Cpt-Quantum/uart-to-ws2812/3d-view.png

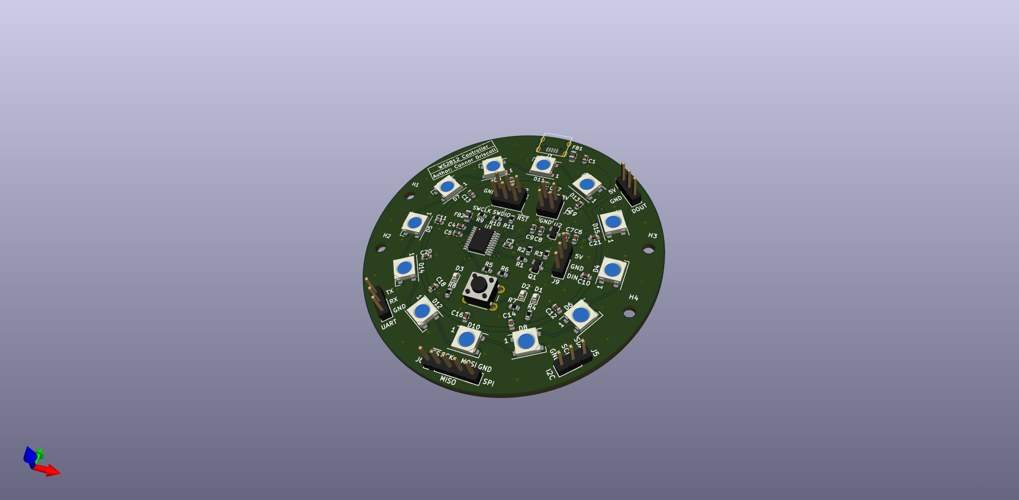
3d-view.png
