Cpt-Quantum/uart-to-ws2812/uart_to_ws2812b.kicad_pcb

## KiCad design uart_to_ws2812b.kicad_pcb (2021-03-27)

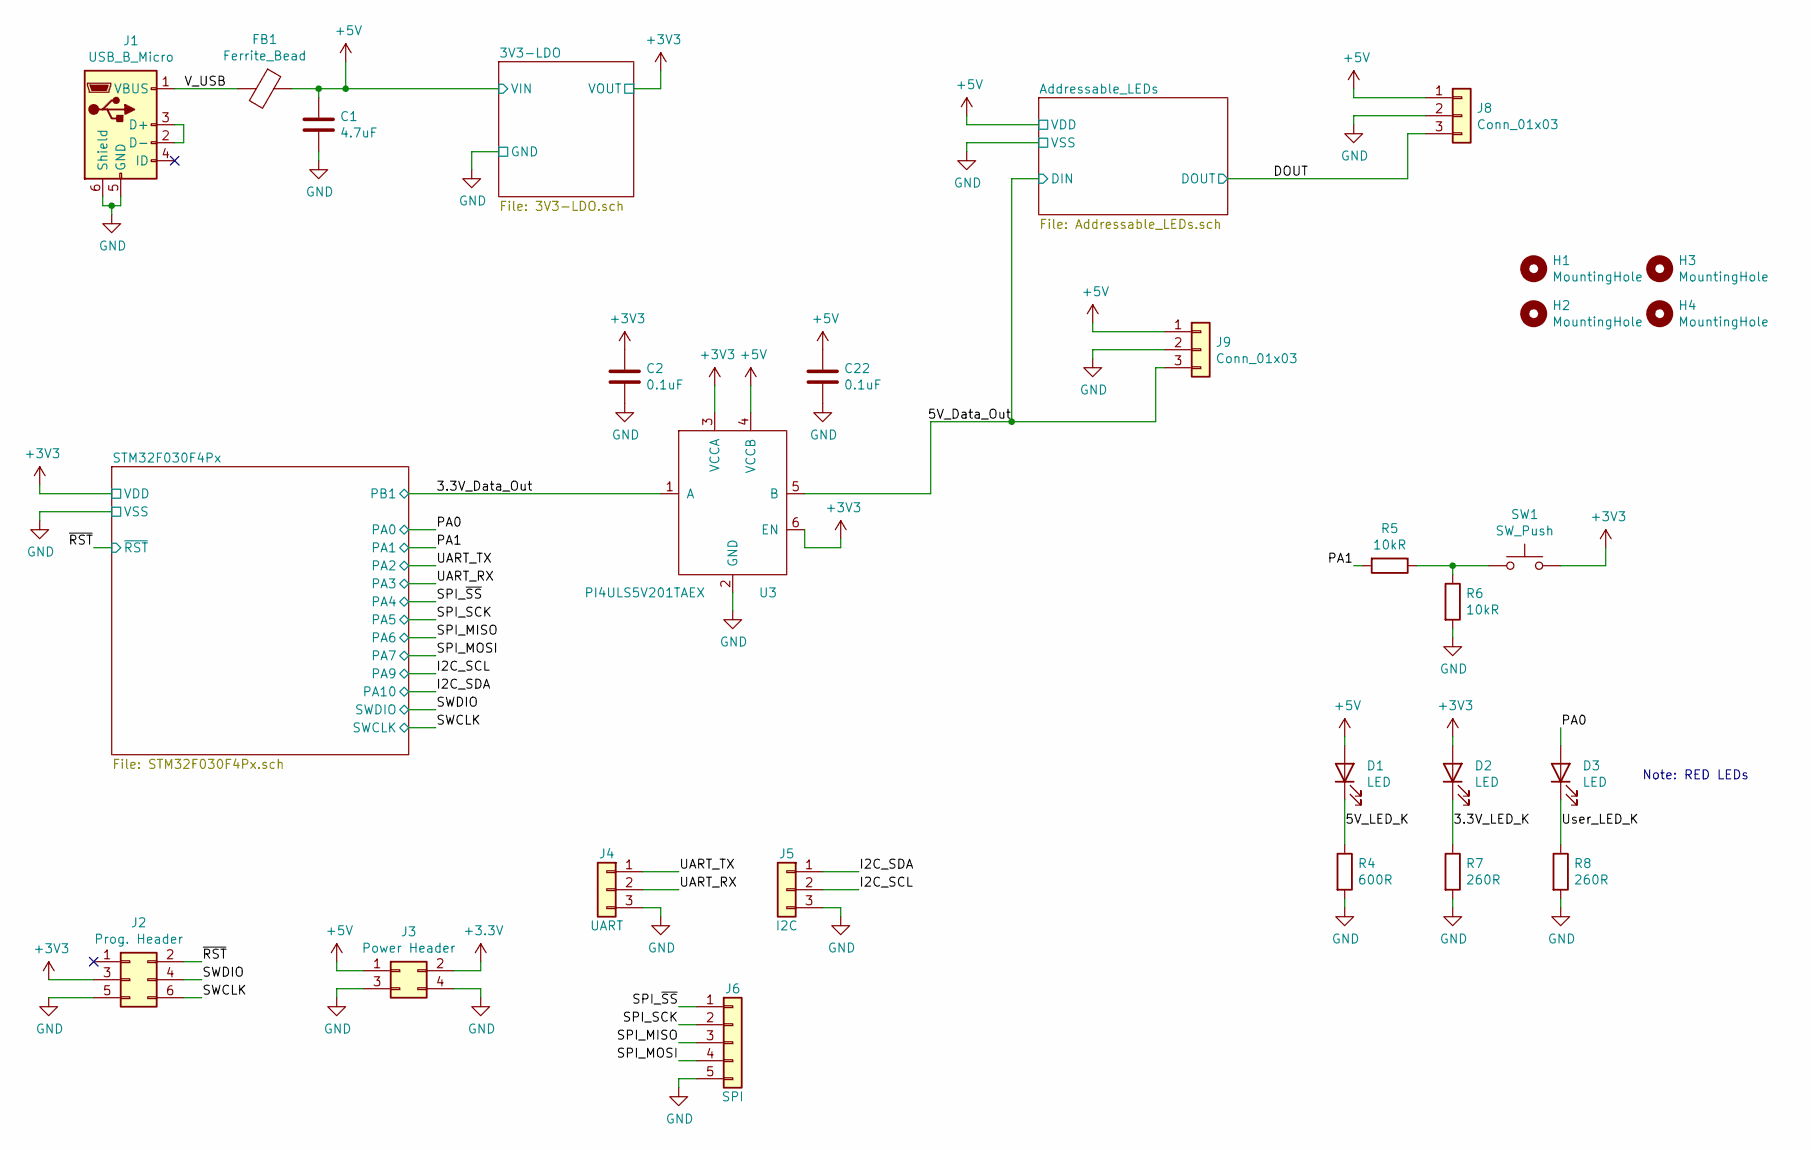
[picture p2: schematic uart_to_ws2812b.sch]

Parts:
C1: 4.7uF; C_0603_1608Metric; Mfr Part # CL10A475KQ8NNNC
C2, C22: 0.1uF; C_0603_1608Metric
D1, D2, D3: LED; LED_0603_1608Metric
FB1: Ferrite_Bead; L_0805_2012Metric
H1, H2, H3, H4: MountingHole; MountingHole_2.5mm
J1: USB_B_Micro; USB-MicroB
J2: Prog. Header; PinHeader_2x03_P2.54mm_Vertical
J3: Power Header; PinHeader_2x02_P2.54mm_Vertical
J4: UART; PinHeader_1x03_P2.54mm_Vertical
J5: I2C; PinHeader_1x03_P2.54mm_Vertical
J6: SPI; PinHeader_1x05_P2.54mm_Vertical
J8, J9: Conn_01x03; PinHeader_1x03_P2.54mm_Vertical
R4: 600R; R_0603_1608Metric
R5, R6: 10kR; R_0603_1608Metric
R7, R8: 260R; R_0603_1608Metric
SW1: SW_Push; SW_PUSH_6mm_H5mm
U3: PI4ULS5V201TAEX; SOT-23-6; Mfr Part # PI4ULS5V201TAEX

Connections:
+3V3: C2.1, D2.2 (A), J2.3, J3.2, SW1.2, U3.3 (VCCA), U3.6 (EN); also elsewhere on the board
+5V: C1.1, C22.1, D1.2 (A), FB1.1, J3.1, J8.1, J9.1, U3.4 (VCCB); also elsewhere on the board
/3.3V_Data_Out: U3.1 (A); also elsewhere on the board
/3.3V_LED_K: D2.1 (K), R7.1
/5V_Data_Out: J9.3, U3.5 (B); also elsewhere on the board
/5V_LED_K: D1.1 (K), R4.1
/DOUT: J8.3; also elsewhere on the board
/I2C_SCL: J5.2; also elsewhere on the board
/I2C_SDA: J5.1; also elsewhere on the board
/PA0: D3.2 (A); also elsewhere on the board
/PA1: R5.2; also elsewhere on the board
/SPI_MISO: J6.3; also elsewhere on the board
/SPI_MOSI: J6.4; also elsewhere on the board
/SPI_SCK: J6.2; also elsewhere on the board
/SPI_~SS: J6.1; also elsewhere on the board
/SWCLK: J2.6; also elsewhere on the board
/SWDIO: J2.4; also elsewhere on the board
/UART_RX: J4.2; also elsewhere on the board
/UART_TX: J4.1; also elsewhere on the board
/User_LED_K: D3.1 (K), R8.1
/V_USB: FB1.2, J1.1 (VBUS)
/~RST: J2.2; also elsewhere on the board
GND: C1.2, C2.2, C22.2, J1.5 (GND), J1.6 (Shield), J2.5, J3.3, J3.4, J4.3, J5.3, J6.5, J8.2, J9.2, R4.2, R6.2, R7.2, R8.2, U3.2 (GND); also elsewhere on the board
unnamed: J1.2 (D-), J1.3 (D+)
unnamed: R5.1, R6.1, SW1.1

Notes on the sheet:
Note: RED LEDs

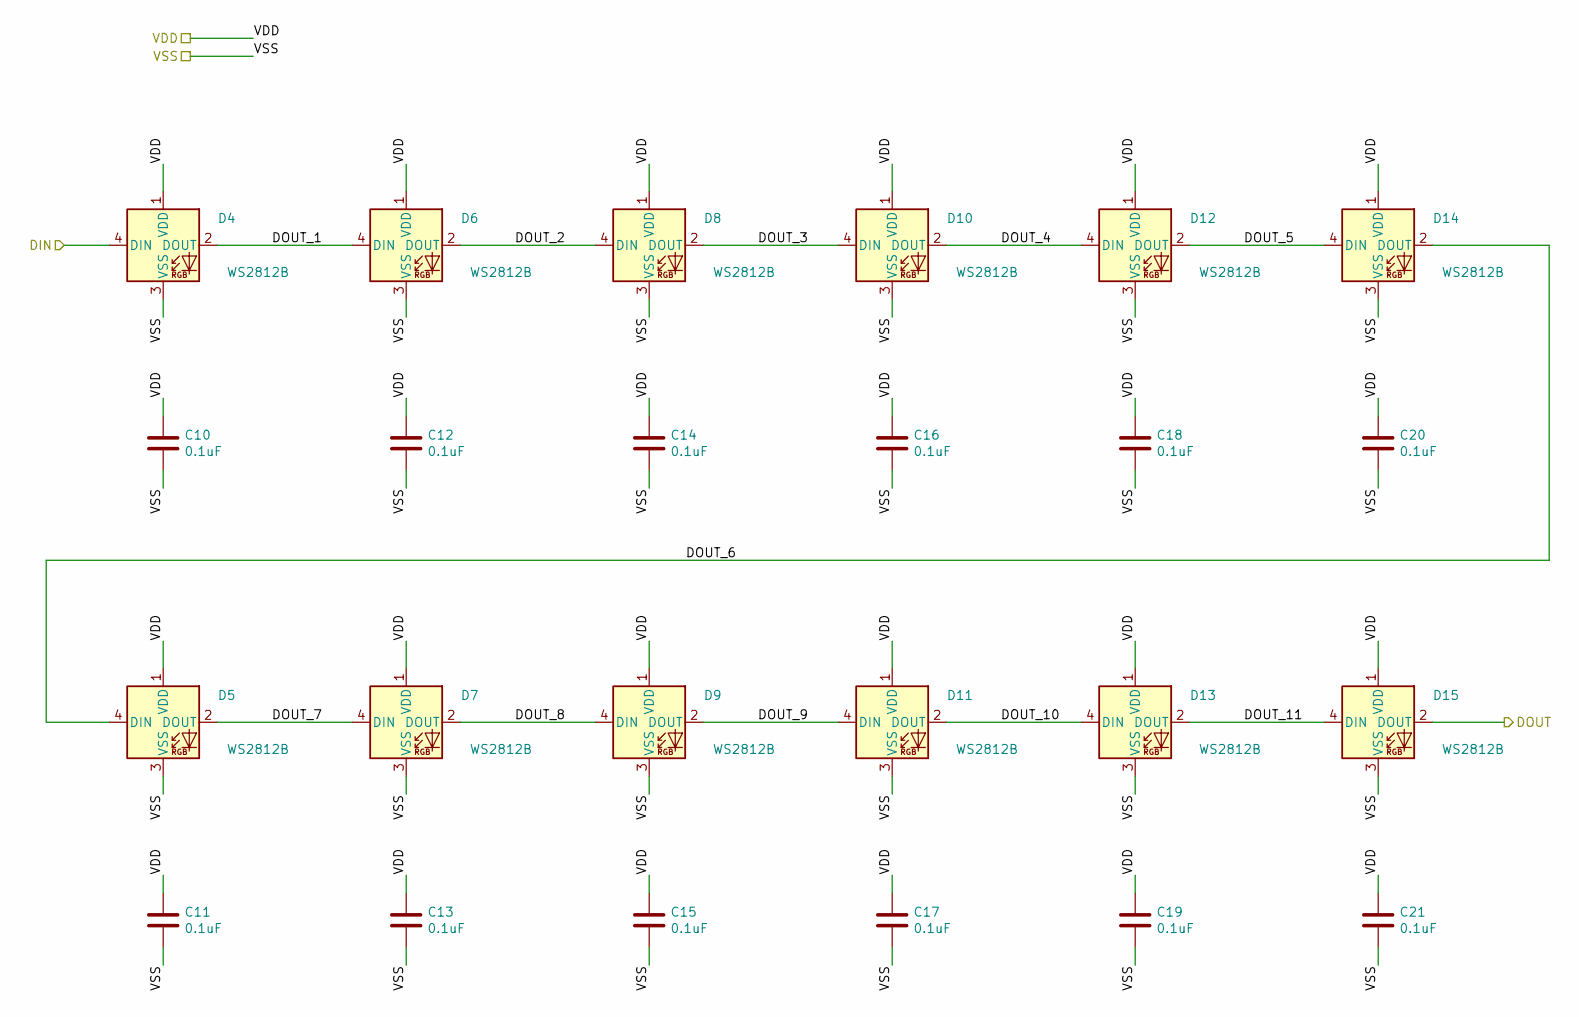
[picture p3: schematic Addressable_LEDs.sch]

Parts:
C10, C11, C12, C13, C14, C15, C16, C17, C18, C19, C20, C21: 0.1uF; C_0603_1608Metric; Mfr Part # 0603F104Z160CT
D4, D5, D6, D7, D8, D9, D10, D11, D12, D13, D14, D15: WS2812B; LED_WS2812B_PLCC4_5.0x5.0mm_P3.2mm; Mfr Part # WS2812E

Connections:
+5V: C10.1, C11.1, C12.1, C13.1, C14.1, C15.1, C16.1, C17.1, C18.1, C19.1, C20.1, C21.1, D4.1 (VDD), D5.1 (VDD), D6.1 (VDD), D7.1 (VDD), D8.1 (VDD), D9.1 (VDD), D10.1 (VDD), D11.1 (VDD), D12.1 (VDD), D13.1 (VDD), D14.1 (VDD), D15.1 (VDD); also elsewhere on the board
/5V_Data_Out: D4.4 (DIN); also elsewhere on the board
/Addressable_LEDs/DOUT_1: D4.2 (DOUT), D6.4 (DIN)
/Addressable_LEDs/DOUT_2: D6.2 (DOUT), D8.4 (DIN)
/Addressable_LEDs/DOUT_3: D8.2 (DOUT), D10.4 (DIN)
/Addressable_LEDs/DOUT_4: D10.2 (DOUT), D12.4 (DIN)
/Addressable_LEDs/DOUT_5: D12.2 (DOUT), D14.4 (DIN)
/Addressable_LEDs/DOUT_6: D5.4 (DIN), D14.2 (DOUT)
/Addressable_LEDs/DOUT_7: D5.2 (DOUT), D7.4 (DIN)
/Addressable_LEDs/DOUT_8: D7.2 (DOUT), D9.4 (DIN)
/Addressable_LEDs/DOUT_9: D9.2 (DOUT), D11.4 (DIN)
/Addressable_LEDs/DOUT_10: D11.2 (DOUT), D13.4 (DIN)
/Addressable_LEDs/DOUT_11: D13.2 (DOUT), D15.4 (DIN)
/DOUT: D15.2 (DOUT); also elsewhere on the board
GND: C10.2, C11.2, C12.2, C13.2, C14.2, C15.2, C16.2, C17.2, C18.2, C19.2, C20.2, C21.2, D4.3 (VSS), D5.3 (VSS), D6.3 (VSS), D7.3 (VSS), D8.3 (VSS), D9.3 (VSS), D10.3 (VSS), D11.3 (VSS), D12.3 (VSS), D13.3 (VSS), D14.3 (VSS), D15.3 (VSS); also elsewhere on the board

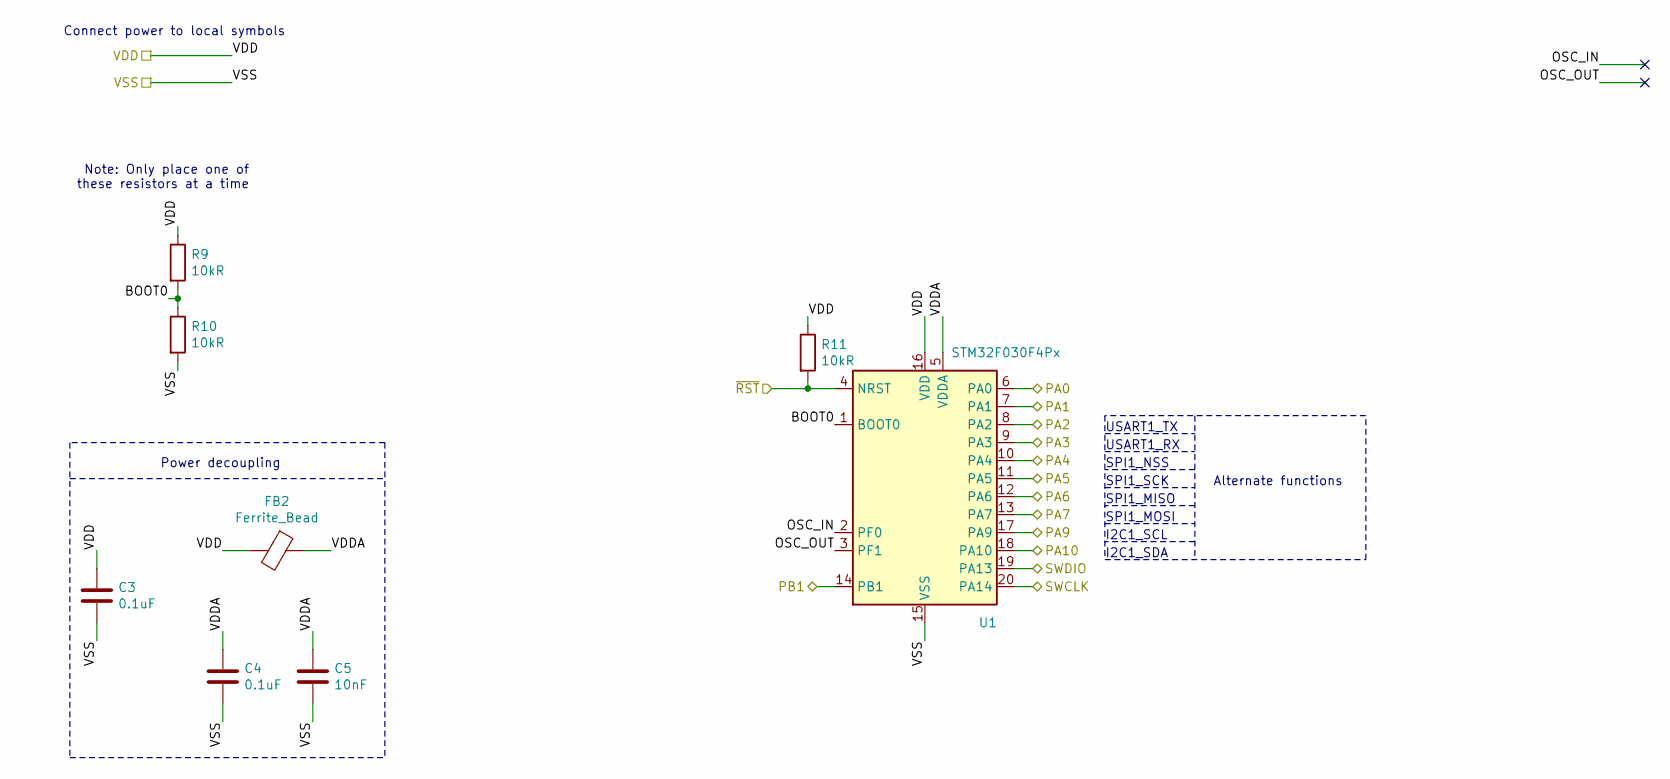
[picture p4: schematic STM32F030F4Px.sch]

Parts:
C3, C4: 0.1uF; C_0603_1608Metric; Mfr Part # 0603F104Z160CT
C5: 10nF; C_0603_1608Metric
FB2: Ferrite_Bead; L_0805_2012Metric
R9, R10, R11: 10kR; R_0603_1608Metric
U1: STM32F030F4Px; TSSOP-20_4.4x6.5mm_P0.65mm; Mfr Part # STM32F030F4P6

Connections:
+3V3: C3.1, FB2.2, R9.1, R11.1, U1.16 (VDD); also elsewhere on the board
/3.3V_Data_Out: U1.14 (PB1); also elsewhere on the board
/I2C_SCL: U1.17 (PA9); also elsewhere on the board
/I2C_SDA: U1.18 (PA10); also elsewhere on the board
/PA0: U1.6 (PA0); also elsewhere on the board
/PA1: U1.7 (PA1); also elsewhere on the board
/SPI_MISO: U1.12 (PA6); also elsewhere on the board
/SPI_MOSI: U1.13 (PA7); also elsewhere on the board
/SPI_SCK: U1.11 (PA5); also elsewhere on the board
/SPI_~SS: U1.10 (PA4); also elsewhere on the board
/STM32F030F4Px/BOOT0: R9.2, R10.1, U1.1 (BOOT0)
/STM32F030F4Px/OSC_IN: U1.2 (PF0)
/STM32F030F4Px/OSC_OUT: U1.3 (PF1)
/STM32F030F4Px/VDDA: C4.1, C5.1, FB2.1, U1.5 (VDDA)
/SWCLK: U1.20 (PA14); also elsewhere on the board
/SWDIO: U1.19 (PA13); also elsewhere on the board
/UART_RX: U1.9 (PA3); also elsewhere on the board
/UART_TX: U1.8 (PA2); also elsewhere on the board
/~RST: R11.2, U1.4 (NRST); also elsewhere on the board
GND: C3.2, C4.2, C5.2, R10.2, U1.15 (VSS); also elsewhere on the board

Notes on the sheet:
USART1_TX
USART1_RX
SPI1_NSS
SPI1_SCK
SPI1_MISO
SPI1_MOSI
I2C1_SDA
I2C1_SCL
Note: Only place one of these resistors at a time
Connect power to local symbols
Power decoupling
Alternate functions

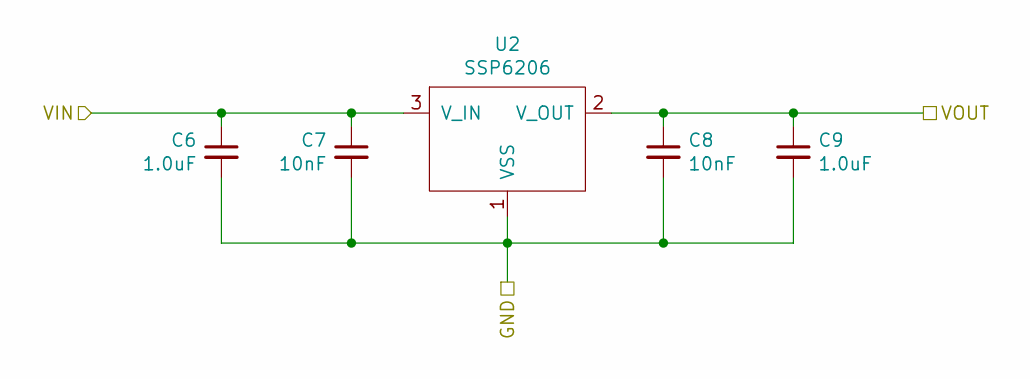
[picture p5: schematic 3V3-LDO.sch]

Parts:
C6, C9: 1.0uF; C_0603_1608Metric; Mfr Part # CL10B105KQ8NNNC
C7, C8: 10nF; C_0603_1608Metric
U2: SSP6206; SOT-23; Mfr Part # SSP6206-33NR

Connections:
+3V3: C8.1, C9.1, U2.2 (V_OUT); also elsewhere on the board
+5V: C6.1, C7.1, U2.3 (V_IN); also elsewhere on the board
GND: C6.2, C7.2, C8.2, C9.2, U2.1 (VSS); also elsewhere on the board

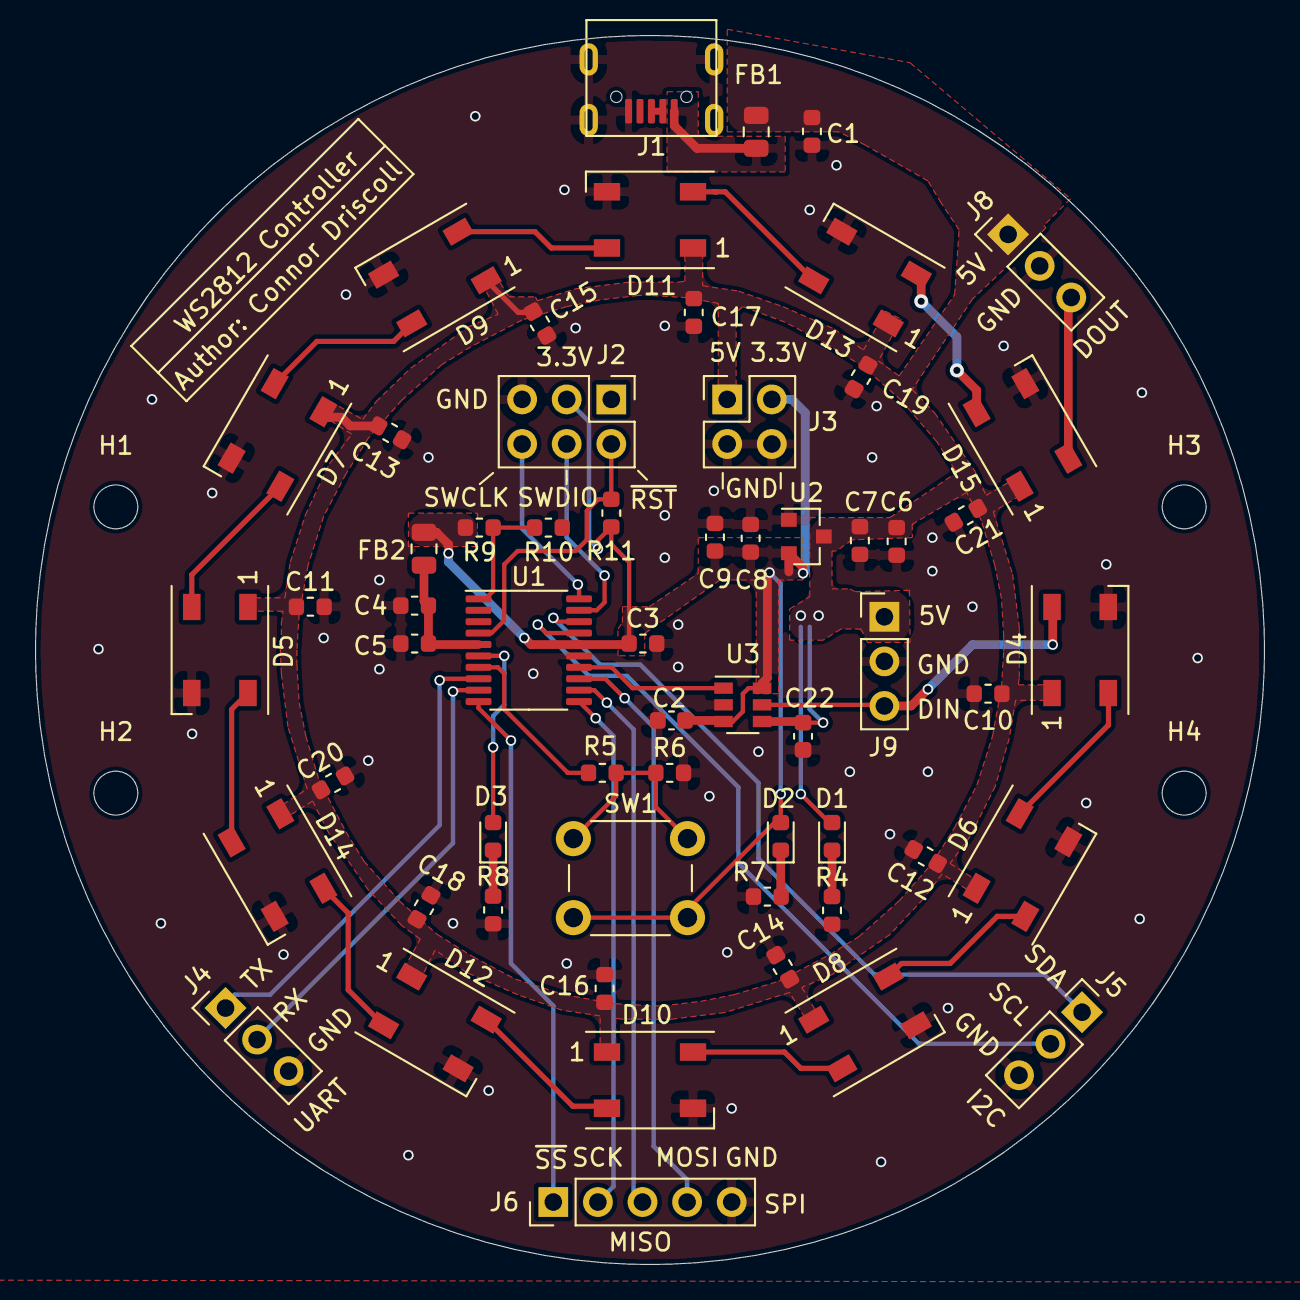
[picture p6: board uart_to_ws2812b.kicad_pcb from above]

Board: 2 copper layers, 70.0 x 70.0 mm, 63 parts (0 on the bottom side), 38 nets.
