Cpt-Quantum/uart-to-ws2812/(commit log)

2020-09-09 Initial schematic/board file commit
    [3V3-LDO.sch, Addressable_LEDs.sch, LED-placement.ods, STM32F030F4Px.sch, uart_to_ws2812b.kicad_pcb, uart_to_ws2812b.sch]
2020-11-07 Updated copper pours to avoid short between V_USB and GND
    [3V3-LDO.sch, Addressable_LEDs.sch, STM32F030F4Px.sch, uart_to_ws2812b.csv, uart_to_ws2812b.kicad_pcb, uart_to_ws2812b.sch]
2020-11-07 Fixed some minor silk screen bugs
    [uart_to_ws2812b.kicad_pcb]
2020-11-14 Shorted D+ and D- to indicate charging mode
    [uart_to_ws2812b.kicad_pcb, uart_to_ws2812b.sch]
2021-01-16 Changed to a level shifting IC for the LED data logic
    [STM32F030F4Px.sch, uart_to_ws2812b.kicad_pcb, uart_to_ws2812b.sch]
2021-03-27 Updated component information with more detail
    [uart_to_ws2812b.csv, uart_to_ws2812b.kicad_pcb, uart_to_ws2812b.sch]
2021-03-27 Changed firmware to use ST device header, added WS2812 support
2021-03-27 Added basic logic to allow support for both RGB and RGBW LEDs
